daveFNbuck/toilet-bot/(commit log)

2015-04-26 Arduino sketch for the sensor
2015-06-05 Fixes types for channel and pipe.
    [sensor.ino]
2015-06-11 Receiver script for raspberry pi
2015-06-11 Fixes indentation, adds indicator lights
    [bathroom_receiver.py]
2015-06-13 Adds more detailed information to the readme for sensor wiring
2015-07-01 Sends toilet status on sensor change
2015-07-03 Blinks indicator light on dead battery
2015-09-28 Displays dead sensor notifications in chat
2015-12-02 Adds a sensor startup delay to allow printDetails to succeed
